ashwanthkumar/varuna/(commit log)

2026-05-30 chore: bootstrap tscircuit project
    Initialize tscircuit project for ESP32-based pump controller PCB.
    Sets up package.json with tscircuit dev dependency, TypeScript config,
    and tscircuit CLI configuration.
2026-05-30 feat: add ESP32 pump controller board
    2-layer 200x120mm PCB that controls a 2HP single-phase motor via an
    L&T MK1 DOL starter. Emulates the MK1 remote START/STOP pushbuttons
    using a 2-channel relay rather than switching the contactor coil directly.
    Power section:
    - HLK-5M05 AC-DC isolated module (230V -> 5V/1A)
    - TMOV14RP275E 275V MOV for mains transient suppression
    - SS12D10G3 onboard SPDT slide switch for controller power
    Motor control:
    - ULN2003ADR Darlington driver (GPIO23/22)
    - 2x SRD-05VDC-SL-C relay with dry-contact outputs
    - WJ128V 3-pole Phoenix terminals for START/STOP wiring to MK1
    Sensor inputs:
    - 2x float switch inputs (dry contact, pull-up, GPIO36/39)
    - 3x SS probe inputs wi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
2026-05-30 docs: add project documentation
    CLAUDE.md: tscircuit rules, Indian BIS electrical standards, AC creepage
    guidance, relay contact verification note, firmware requirements summary,
    and sensor redesign context for future sessions.
    parts.txt: full BOM with JLCPCB C-numbers, local-buy items, and install
    note for the upstream 2A MCB (not on PCB).
    firmware.txt: complete firmware spec including GPIO pinout, probe AC
    excitation protocol, relay pulse sequences, automation logic, safety
    rules, and MQTT topic structure.
2026-05-30 chore: add .nvmrc, claude skills, and update .gitignore
    Pin Node.js to v20 via .nvmrc for consistent builds across machines.
    Add .claude/skills/tscircuit for the tscircuit PCB design skill used
    throughout this project. Exclude session-specific files (settings.local.json,
    scheduled_tasks.lock) from version control.
2026-05-30 fix: move J_AC inward, update AC trace waypoints
    J_AC was too close to the top-left mounting hole H1 (courtyard edge at
    x=-97.75, H1 at x=-97). Moved J_AC from pcbX=-90,pcbY=50 to
    pcbX=-80,pcbY=44 giving 9mm clearance from H1.
    Updated hand-routed AC trace waypoints to match new pin positions:
    - L pin: -75,44 (was -85,50) — drops to y=35 above RV1 courtyard
    - N pin: -80,44 (was -90,50) — exits left to dedicated x=-93 lane
    - E pin: -85,44 (was -95,50) — short earth stub
    Creepage between L and N lanes remains >17mm centre-to-centre.
2026-05-30 refactor: compact layout to 200x100mm JLCPCB standard size
    Reduces board height from 120mm to 100mm (JLCPCB standard).
    - Relay section (RLY1/2, J_START/STOP) moved 26mm closer to ESP_R,
    eliminating the empty strip between U_DRV and the relays
    - LED/R_LED relocated to upper-center area (was lower-right)
    - Bottom sensor section raised 8mm to fit within 100mm height:
    connectors J_FL1/2/J_PR: y=-50 -> y=-42
    TVS arrays: y=-40 -> y=-32
    All front-end passives shifted up proportionally
    - Probe3 passives shifted left (x=-20/-33) to clear ESP_L courtyard
    - Mounting holes repositioned to board corners (x=±95/70, y=±46)
    - LED1 supplier part number added (JLCPCB C965799) — fixes footprint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
2026-05-30 refactor: redistribute components across 200x100mm board
    Sensor connectors moved from bottom-left (x=-70..-25) to bottom-center
    (x=-10..+22) directly below the ESP32 + relay section, eliminating the
    large empty strip in the lower-left.
    Relay section shifted right (relay pcbX: 44->56, terminals: 64->76)
    and U_DRV moved closer to ESP_R (pcbX: 40->32) to fill the empty
    upper-right strip.
    Mounting holes now symmetric at x=±95 (H2/H4 were at x=70).
    LED1 relocated to lower-center (y=-10) between sensor and relay sections.
2026-05-30 feat: add LEDs/buttons, move J_AC to bottom, SW1 vertical
    New components:
    - LED_PWR (red, 5V always-on power indicator)
    - LED_MOTOR (yellow, GPIO17 motor running)
    - LED_FL1/FL2 (blue, GPIO19/18 float switch state)
    - LED_PRB (blue, GPIO5 probe sensor active)
    - BTN_PAIR (GPIO0 momentary, WiFi pairing mode)
    - BTN_RST (GPIO16 momentary, factory reset)
    Layout changes:
    - J_AC moved from top (y=44) to bottom edge (y=-42) aligned with
    sensor connectors — all input connectors now on same bottom row
    - SW1 rotated 90deg (vertical up/down slide), positioned at right
    edge of HLK-5M05 module (x=-58)
    - Relay section moved to y=16/-14 to make room for LED strip
    - LED row at y=44 spans x=22..88 across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
2026-05-30 fix: move SW1 below top board edge (y=42->34)
2026-05-30 docs: update firmware and BOM for new LEDs and buttons
    firmware.txt:
    - Full GPIO pinout including all 5 indicator LEDs (GPIO4/17/19/18/5),
    pairing button (GPIO0) and factory reset button (GPIO16)
    - LED behaviour guide: what each colour/state means at runtime
    - Button hold-time spec: 3s for pairing, 5s for factory reset
    - Boot sequence order — GPIO33 must go LOW before anything else
    - LED_PWR noted as hardware-only (no GPIO, wired to 5V rail)
    parts.txt:
    - Added all new BOM lines: LED_PWR/MOTOR/FL1/FL2/PRB + resistors,
    BTN_PAIR/BTN_RST + pull-up resistors and debounce caps
    - Expanded passive section with per-reference descriptions
    - Added SS probes, float switches, CAT6 cable to site-in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
2026-05-30 feat: drive DOL contactor coil directly instead of MK1 emulation
    Replaces the L&T MK1 remote-pushbutton emulation with direct control of
    an external DOL contactor coil. The board now IS the DOL controller (with
    an external DIN-rail contactor + thermal overload relay).
    Circuit changes:
    - Remove RLY2, J_START, J_STOP (no more MK1 START/STOP terminals)
    - RLY1 -> RLY_MOTOR: switches 230VAC contactor coil via its NO contact
    (COM <- net.LIVE, NO -> J_COIL.A1; coil A2 <- net.NEUTRAL)
    - Add J_COIL (2-pole): A1 switched-Live + A2 Neutral to contactor coil
    - Add J_OL (2-pole) + RU/RS/CF front-end: thermal overload aux NC sense
    on GPIO21 (HIGH = tripped)
    - Add named net.LIVE / net.NEUTRAL tapped a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
2026-05-30 docs: clean up remaining MK1/pulse references in firmware LED section
    LED_MOTOR description and behaviour guide still mentioned START/STOP
    pulses and MK1 latching from the old design. Updated to reflect the
    held contactor-coil control (LED tracks GPIO23 state).
2026-05-30 docs: finish MK1->contactor cleanup in firmware and CLAUDE
    Replace remaining stale MK1 pulse references with held contactor-coil
    control across firmware.txt MOTOR CONTROL + LED sections and CLAUDE.md
    quick-reference (relay, overload sense, boot safety, connector list).
2026-05-30 docs: fix firmware MOTOR CONTROL block (held coil, not MK1 pulse)
2026-05-30 docs: lock in final external DOL parts (LEYDEN CJX2-3211 + MaK-1 2P)
    - Contactor: LEYDEN CJX2-3211 (32A AC-3, 230V coil), with single-phase
    pole-paralleling wiring note for longer contact life
    - Overload: MAGNUM MaK-1 2P (13-21A, single-phase), dial to ~13A
    - Warn against AC3-10A enclosed manual starters (MCHK-1) — undersized
    and button-latch logic conflicts with ESP32 automation
2026-05-30 fix: align bottom-edge connector wire-entry faces on one line
    J_AC, J_FL1, J_FL2 and J_PR have different body depths (WJ128V 5.58mm,
    WJ500V 4.77mm, DB128L 5.36mm). Pad rows were aligned at y=-42 but the
    visible connector bodies stuck out by different amounts.
    Offset each pcbY by its body depth so all front (wire-entry) faces sit
    flush at y=-47.58: J_AC=-42.0, J_PR=-42.22, J_FL=-42.81. Updated J_AC
    hand-routed trace waypoints back to y=-42.
2026-05-30 fix: move power LED next to the SW1 ON/OFF switch
    LED_PWR + R_PWR relocated from the top LED row (x=22,28 y=44) to beside
    the SW1 power switch (x=-70, y=32/37) so the user sees controller power
    status right at the ON/OFF control.
2026-05-30 feat: group all 6 LEDs in one labelled top row for transparent cover
    Regroup the scattered indicator LEDs (PWR was by the switch, others in a
    right-side row) into a single centred row along the top edge so all are
    visible through a transparent front cover.
    - 6 LEDs evenly spaced 13mm apart at y=45, centred on board
    (x = -32.5 .. +32.5): PWR(red) WIFI(grn) MOTOR(yel) FL1/FL2/PRB(blu)
    - Bold silkscreen labels (fontSize 1.5) above each at y=49
    - Resistors tucked below each LED at y=40
    - Removed the JST connector approach (kept LEDs on-board per design change)
    Build clean: Circuits 1 passed, 0 overlap errors.
2026-05-30 feat: relocate PAIR/RESET buttons below HLK with labels
    Move BTN_PAIR (GPIO0) and BTN_RST (GPIO16) from the unlabelled mid-board
    spot to below the HLK module at (-76,-14) and (-60,-14), with bold
    PAIR/RESET silkscreen labels for the transparent-cover design.
    parts.txt: spec tall THT tactile buttons (9-13mm actuator) to reach cover
    holes; note the grouped labelled LED row visible through the window.
    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
2026-05-30 feat: use real TS-1101-C-W tactile button for PAIR/RESET
    Replace generic <pushbutton> with imported TS-1101-C-W (JLC C318938),
    a 6x6mm through-hole 4-pin tactile switch (405k stock). Wired SPST:
    pin1 -> GND, pin2 -> GPIO/pull-up node. Both BTN_PAIR (GPIO0) and
    BTN_RST (GPIO16) use it.
    (Earlier C2997587 was a mis-search that imported an inductor; removed.)
    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
2026-05-30 docs: reference TS-1101-C-W (C318938) for PAIR/RESET buttons in BOM
2026-05-30 feat: add J_DBG 3-pin UART debug header for field servicing
    Add a 3-pin male header (TX/RX/GND) broken out from the ESP32 UART0
    (GPIO1/GPIO3) above U_DRV, with a bold silkscreen label. Lets a
    technician clip a 3V3 USB-TTL adapter for serial logs without removing
    the DevKit. Firmware flashing still uses the DevKit USB port; this is
    read/log access through a cover hole.
    Decided against a USB-C + bridge on the mainboard since the DevKit
    already has USB; this is the minimal-cost debug provision.
    Docs: firmware.txt notes GPIO1/3 are the default Serial UART (logs
    appear with no setup); parts.txt lists J_DBG.
    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
2026-05-30 fix: center PAIR/RESET buttons in the J_AC--J_FL1 gap
    Shift the button pair +23mm right so it is horizontally centred (midpoint
    x=-44) in the empty bottom-edge gap between J_AC (right edge -72) and
    J_FL1 (left edge -16). BTN_PAIR -76->-53, BTN_RST -58->-35, with labels
    and passives moved to match.
    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
2026-05-30 fix: center J_DBG in J_AC--J_FL1 gap, return buttons below HLK
    Clarified intent: it was the debug header (not the buttons) that should
    be centred in the bottom-edge gap. Move J_DBG to x=-44 (midpoint between
    J_AC right edge -72 and J_FL1 left edge -16). Return BTN_PAIR/BTN_RST to
    their grouped spot below the HLK module (x=-76/-58).
    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
2026-05-30 fix: rotate J_DBG vertical to face bottom edge
    pcbRotation=90 so the 3 debug pins (TX/RX/GND) stack vertically and the
    connector faces the board bottom edge for a clip-on USB-TTL adapter,
    matching the other bottom-edge connectors.
    Confirmed 3 pins is sufficient (serial-log tap only) — flashing and
    auto-reset use the DevKit USB, so the 6-pin FTDI signals (3V3/EN/GPIO0)
    are not needed.
    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
2026-05-30 fix: place J_DBG on bottom connector row, right-angle for edge plug
    Move J_DBG down to y=-42 (same row as J_AC/J_FL/J_PR) and make it a
    right-angle male header so the 3 pins (TX/RX/GND) exit toward the bottom
    board edge, allowing a USB-TTL lead to plug in from below the enclosure
    like the screw terminals. Centred at x=-44 in the J_AC--J_FL1 gap.
    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
2026-05-30 docs(silk): add ESP32 DevKit orientation guide on PCB
    Add silkscreen text between the two DevKit header rows:
    - "ESP32 DEVKIT" centre label
    - "USB / VIN ^ TOP" at the top (pin19/V5 end)
    - "3V3 / ANTENNA v BOT" at the bottom (pin1/V3V3 end)
    Tells the assembler which way to seat the DevKit: USB/programming port
    faces the top board edge, PCB antenna faces the bottom. Anchored to the
    unambiguous V3V3(pin1, bottom) / V5(pin19, top) header pins.
    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
2026-05-30 fix: J_DBG right-angle opening faces top, bottom flush with row
    - Correct part: S3B-XH-A JST-XH 3-pin right-angle (JLC C157928).
    - pcbRotation=0 so the side-entry opening faces the board interior (top):
    debug lead plugs in from ABOVE the PCB surface; nothing protrudes past
    the bottom mounting edge or adds depth below the board.
    - pcbY=-44.9 sets the connector bottom edge to -47.59, flush with
    J_AC(-47.58)/J_FL/J_PR on the same bottom line.
    - parts.txt C-number corrected to C157928.
    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
2026-05-30 docs: add INSTALL.txt panel wiring guide; J_DBG faces outward
    INSTALL.txt: electrician-facing install and panel wiring guide covering
    board power (J_AC), contactor coil control (J_COIL to A1/A2), overload
    trip sense (J_OL to 95/96), the off-board motor power path, CAT6 sensor
    wiring, local controls and LEDs, DevKit orientation, and first power-up
    dry-run safety check.
    Also includes the J_DBG outward-facing fix (pcbRotation 180, opening to
    the bottom edge, bottom flush at -47.58 with J_AC/J_FL/J_PR).
    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
2026-05-30 feat: add BL0942 energy metering (CT + ZMPT101B), move buttons right
    Adds an isolated energy-metering block in the freed below-HLK area for
    current/voltage/power sensing -> enables current-based dry-run detection
    (pump amps drop when it loses prime) on top of the probe-based check.
    - BL0942 metering IC (JLC C2909509), digital link on GPIO25/26
    - ZMPT101B voltage transformer (C111858): mains voltage sense, isolated,
    primary via 2x series 100k off net.LIVE/NEUTRAL, secondary burden to VP
    - J_CT 2-pole terminal (bottom row, outward) for an EXTERNAL current
    transformer clamped on the motor Live; R_BUR burden -> BL0942 IP/IN
    - PAIR/RESET buttons relocated to top-right (x=58/74, y=44) to make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
2026-05-30 docs: document current-based dry-run + metering wiring
    - firmware.txt: add current-based dry-run rule to automation logic
    (stop when BL0942 current drops below ~80% of healthy baseline; also
    over-current jam stop), with calibration note. GPIO25/26 metering link.
    - parts.txt: BL0942 (C2909509), ZMPT101B (C111858), J_CT terminal, and
    external CT note; conditioning passives flagged as reference values.
    - INSTALL.txt: section 5b — clamp CT on motor Live -> J_CT; CT selection
    and why current sensing gives independent dry-run protection.
2026-05-30 docs(install): add section 5b CT/energy metering wiring
2026-05-30 Revert "docs(install): add section 5b CT/energy metering wiring"
    This reverts commit 0e7af521eb88f92567db6d79faf30ad8d07b7b5d.
2026-05-30 Revert "docs: document current-based dry-run + metering wiring"
    This reverts commit edefd1b0b36f8fbf4f8cb8e4ac75057dd02526d6.
2026-05-30 Revert "feat: add BL0942 energy metering (CT + ZMPT101B), move buttons right"
    This reverts commit 3ccac0aa13f4f01e55f13050e6b470233002aa22.
2026-05-30 docs: capture deferred energy-metering research in notes/
    Records the V/I/energy-metering investigation (removed from the board for
    now) so it can be re-added later without redoing the research: the three
    approaches (external clamp CT / on-board CT / energy-meter IC), JLCPCB
    parts (BL0942 C2909509, ZMPT101B C111858, ZMCT103C C94571), the reverted
    design details, firmware hooks, and the git commits to cherry-pick.
2026-05-30 chore: restructure into pcb/ + add README, programming notes
    Move the tscircuit PCB project into pcb/ (index.circuit.tsx, imports/,
    parts.txt, package.json, configs, node_modules, snapshots) so firmware/
    and enclosure/ can be added as siblings later. Run tsci from pcb/.
    - README.md (root): project overview, repo layout, build/run, install summary
    - notes/bare-module-migration.md: checklist to move from DevKit to a soldered
    ESP32-WROOM-32 (LDO, EN/GPIO0 boot circuit, 6-pin prog header / USB-UART, OTA)
    - firmware.txt: add PROGRAMMING / FLASHING section (DevKit USB now; bare-module
    header + OTA later)
    - CLAUDE.md: document new repo structure; repoint parts.txt link to pcb/
    Build verified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
2026-05-30 docs(firmware): add PROGRAMMING / FLASHING section
    DevKit USB now; bare-module 6-pin header + boot circuit later (see
    notes/bare-module-migration.md); OTA for field updates.
2026-05-30 docs: add Amazon purchase links for contactor + overload relay
    Add buy links to the LEYDEN CJX2-3211 contactor (B0BZQNCKWY) and MAGNUM
    MaK-1 2P overload relay (B0F5HTJWTT) in pcb/parts.txt, INSTALL.txt §1,
    and a new README "External DOL parts" table with wiring + buy columns.
2026-05-30 feat(enclosure): add parametric OpenSCAD single-box enclosure
    Single box holding the Varuna PCB (on M3 standoffs) + a 35mm DIN rail for
    the external contactor + overload. Cutouts derived from the PCB coords in
    pcb/index.circuit.tsx: LED window, PAIR/RESET button holes, SW1 slot,
    bottom + right cable bands. base() and lid() both render manifold/clean in
    OpenSCAD. DIN-stack/depth params are reference values to measure + tune.
    Adds enclosure/varuna-enclosure.scad + enclosure/README.md (render/export
    commands, what auto-aligns, and the params to verify before printing).
    [varuna-enclosure.scad]
2026-05-30 feat(enclosure): side-hinged single box with DIN/cable polish
    Replace the prior simple box with a side-hinged, lid-installed
    enclosure designed for wall-mounting:
    - Hinge on EAST wall (door swings left), DIN rail at TOP of cavity,
    PCB at BOTTOM. Print-in-place hinge plus separate-print options
    (part="open"/"hinged"/"base"/"lid").
    - Lid auto-flipped for printing (part="lid"); cutouts designed in
    installed coords so the LED column, button holes, and SW1 slot
    line up with the PCB after the flip.
    - DIN rail now properly attached: two M3 self-tap screw bosses on
    the cavity floor (140 mm pitch), drill matching M3 clearance
    holes in a standard 35 mm top-hat rail and screw it down.
    - Ne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
    [varuna-enclosure.scad]
2026-05-30 refactor(pcb): vertical layout + 30-pin NodeMCU ESP target
    Two coordinated PCB changes that ship together because they touch
    the same source file:
    LAYOUT REWORK (for the new enclosure)
    - J_AC, J_OL, J_COIL moved to the TOP edge (face the DIN-rail
    components above the board inside the enclosure).
    - SW1 moved to BOTTOM-LEFT (vertical slide via pcbRotation=90).
    - 6 status LEDs reorganized into a VERTICAL COLUMN on the right
    edge (PWR top -> PRB bottom, 13 mm pitch) for the new vertical
    LED window in the lid.
    - Overload front-end passives migrated up to follow J_OL.
    - AC creepage routes reset to autorouter; will re-hand-route
    once placement is final.
    - Project credits silk added ("Proje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
2026-05-30 feat(firmware): ESP32 pump controller with web UI, AUTO/semi-auto modes
    Implement the Varuna firmware per firmware.txt:
    - AUTO level control + semi-automatic force-start (runs to exit condition)
    - Self-contained web dashboard (PROGMEM) with status/cmd/config JSON API
    - Pulsed probe excitation, debounced floats, overload latch, dry-run lockout
    - BTN_PAIR config portal (3s) and BTN_RST factory reset (5s)
    - All 5 status LEDs driven per spec; non-blocking LED scheduler
    - Optional MQTT, guarded ArduinoOTA, 30s hardware watchdog
    - PlatformIO project layout with pins/config/web_ui modules
    [config.h, main.cpp, pins.h]
2026-05-30 fix(firmware): harden WDT init, fault-guard startMotor, redirect send
    - Guard esp_task_wdt_init for Arduino-ESP32 core 2.x vs 3.x API change
    - Block startMotor on any latched fault (defense-in-depth for web/MQTT paths)
    - Use 3-arg server.send for the 302 catch-all redirect (portable overload)
    - README: firmware/ is now implemented (PlatformIO), document modes/UI/buttons
    [main.cpp]
